FlorinAndrei/WeatherStation/(commit log)

2019-10-25 buffer the read thread
2019-10-25 upload device images
2019-10-25 include device images
2019-10-27 move Arduino file into its own folder
    Arduino IDE requires a certain folder structure
2019-10-27 announce when writer thread is ready
2019-10-28 pressure is now type float
2019-10-28 threads talk at cusp between seconds
2019-10-28 pass all args to writer thread
2019-10-28 move serial to reader thread
2019-10-28 give threads names in the process list
2019-10-30 debug print made clearer
2019-11-01 mention Arduino freeze issue
2019-11-03 standardize relaxation time between sensor reads
2019-11-03 mention loop() freeze bug and forum thread
2019-11-04 added Nordic Semi Devzone thread
2019-11-10 reopen serial when Arduino is reset
    [weather_station.py]
2019-12-05 linear regression to correct the temperature sensor
    The temperature sensor on the Arduino is pretty inacurrate. I need to take lots of readings comparing it with a known good sensor (a weather station nearby) and run linear regression to calculate the correction.
    [weather-temp.csv]
2019-12-07 more data collected
    [weather-temp.csv]
2019-12-07 one more data point
    [weather-temp.csv]
2019-12-08 link the Arduino code
2019-12-08 one more datapoint
    [weather-temp.csv]
2019-12-09 note about excess heat and temperature sensor
